sustainablelab/eurorack/readme-derivative.md

Derivative Work by Curry Goat Tea House

# Module builds in the USA
I am not changing the design. I simply wish to fab the boards by my usual flow
in the US and using parts available in the US. There changes are minor but
tedious. I hope to save others from repeating this effort.

These are minor changes to repo `github.com/pichenettes/eurorack.git`. The
changes allow me to build a similar module in the USA using a prototyping
turnkey service, either *MacroFab* or *PCB:NG*. For front panels, I either set
up files for laser cutting, or I order a bare PCB from *OSHPARK*.

The `pichenettes` design is for build in Europe. There are some BOM items
unavailable in the USA. Also, my PCB fab has different requirements from the fab
used by `pichenettes`. And my PCB assembly service only does surface mount. I
assemble the through-hole parts myself.

The purpose of the derivative work is a USA-compatible version. I only change
the PCB files and BOM files. I add my own PCB manufacturing files, and
supplement the front panel files with design files for laser cutter or PCB fab,
because I have access to these manufacturing services for prototyping
quantities.

I do not change the firmware. I do my best to keep this fork up to date with the
original `pichenettes` repo so that it always has the latest firmware.

## Stay up to date with design at `pichenettes`
I use Git to stay up to date. This is how the remotes are set up in my local
clone:

```bash
$ git remote -v
origin	https://github.com/sustainablelab/eurorack (fetch)
origin	https://github.com/sustainablelab/eurorack (push)
upstream	https://github.com/pichenettes/eurorack.git (fetch)
upstream	https://github.com/pichenettes/eurorack.git (push)
```

I sync to `pichenettes`:
```bash
git pull upstream master
```

And I push all derivative work to my fork. My fork is the remote repo you are
looking at now.

```bash
$ git push
```

# Boring repo additions
## EAGLE Project for latest work state
- [x] add an EAGLE project to the `eurorack` repo to store EAGLE state

The EAGLE project purpose is to save the state of the working environment for
the last PCB I was working with in the `eurorack` repo. It lowers the friction
in switching between `eurorack` work and my day-job work.

For example, if I am looking at the `shades` schematic and board files, I close
the project, not the files. Then when I reopen the project, those files open up.
Similarly, whatever libraries are active are reactivated, the grid settings in
the board file are loaded, etc.

## Private folder for invoices and receipts
- [x] add `_private`

`_private` holds paperwork no one else would be interested in: invoices and
receipts for parts orders and PCB orders.

# Price Module Builds
I use PCB:NG in Brooklyn. They are professional, have a quick turn time, and are
the cheapest prototyping service I know of. The only drawback is that they only
assemble surface mount parts. A lot of Eurorack parts are through-hole.

As ridiculous as it feels to pay $300-$500 for a module, there is no
cost-savings to order a single board. PCB:NG requires ordering six boards.
MacroFab allows ordering a single board, but the cost is very high. Set the
through-hole parts as DNP and the cost of a module like Shades or Ears is the
same as buying the module new. In addition:

- most modules have a metal panel,
    - I still need to laser cut a proxy for the front panel
    - in the case of Ears, the front panel is another PCB
    - this is cheap to order from OSHPark, but still, that's another PCB to
      order!
- I still need to solder the through-hole parts by hand
- I have to deal with procuring the 3.5mm jack that matches the PCB footprint

# Eurorack module design
The Eurorack standard comes from the Eurorack card standard for inserting PCB
cards into a rack-mounted backplane. Eurorack eliminates a lot of the
requirements to reduce the module COGs (cost of goods). The power supply bus
cabling replaces the backplane. It is a defacto standard. Much of Eurorack is a
defacto standard. You won't find a single-answer for compatibility. Just look at
popular modules. Since Mutable Instruments is open-source, and derivative
modules are open-source, I use this as my reference. I also have a Moog case
that I take measurements from.

## Jacks
This took me by surprise. Jacks are in no way standardized. The PCB footprint
for the jack in a module design *must* match the specific jack if the jack pins
solder directly to the PCB. So, jacks. Here we go.

### Background
Jacks come with different diameters, mono or stereo, switched or unswitched, and
panel mounted (solder wires to the jack pins) or PCB mounted (jack pins solder
direct to the PCB).

The typical Eurorack jack is a 3.5mm, mono, switched, PCB-mounted jack.
Most Eurorack modules mount the PCB parallel to the front panel, so the jack
pins are axial with the jack.

### function of the three pins on a switched mono jack
The three pins are tip, sleeve, and a normally-close (N/C) switch.

The two important pins are sleeve and tip. These carry the signal on the audio
cable. Sleeve ties to a 0V reference in the circuit. Tip is the signal input or
output.

The switch pin functionality depends on the module. Normally-closed means the
switch pin shorts to the tip when no cable is inserted and opens when a cable is
inserted. There's a surprising number of clever ways to use such switch action.
Here are three examples from Mutable Instruments.

### switch pin usage examples from Mutable Instruments

#### Elements
- all the jacks on Elements do not use the switch connection
- the switch pin is left unconnected

#### Ears
- the sleeve pin connects to a `0V` reference
- the piezeo element is a two-terminal device
    - one terminal ties to the `0V` reference
- the switch pin connects to the other terminal of the piezo element
- when nothing is plugged into the jack, the switch pin shorts to the tip pin,
  so the piezo element connects to the input stage
- when a device is plugged in, the switch pin opens and the piezo element is no
  longer connected to the input stage

#### Shades
- all the jacks on Shades use the switch connection
- the default reference to the jack inputs is `0V`
- the switch pin, in conjunction with the three-pin header, provides an
  alternative default reference to the jack inputs of either `+5V` or `+10V`
- design:
    - tie the switch to the middle pin of a three-pin header
    - the outer pins are voltage references
    - the three-pin header is not accessible via the front panel
    - the user puts a jumper on the three-pin header prior to installing the
      module in their eurorack
    - the jumper ties the `switch` pin to either `+5V` or `+10V`
    - so the input to the jack can default to `+5V` or `+10V`
    - removing the jumper results in defaulting to `0V` because the op-amp
      is in a negative feedback configuration:
        - non-inverting terminal is tied to a `0V` reference
        - therefore the inverting terminal is driven to `0V`
        - the jack tip pin is connects to the inverting terminal via the
          the `10kΩ` pot and the `100kΩ` resistor

### Threaded
The jacks take a lot of abuse, so they must be attached to the front panel via a
threaded nut. Otherwise the constant plugging and unplugging of patch cables
could damage the jack solder joints or the stress could transfer to the PCB the
jack is mounted on.

This threaded nut requirement is peculiar to Eurorack. Headphone and USB jacks
on regular consumer electronics have a similar concern, and those are only PCB
mounted, and surface mount at that! But the stress in a Eurorack and the
reliability demands are greater. Jacks in consumer electronics are almost
always at a right angle to the PCB, so plugging a cable does not transfer the
stress to the PCB. And to protect the solder joint of the jack, there is usually
a pair of mounting pins that constrain the jack position on the PCB. Eurorack
usually requires the PCB and front panel planes to be parallel, and the number
of plugging/unplugging cycles is *much* higher. And unlike a consumer headphone
jack, once a Eurorack module jack starts to go, the module is unusable.

### Beware of variety and availability
- there are *many* 3.5mm mono jacks that solder to a PCB
- as of this 2019 writing, *none* of the ones used in Eurorack designs are
  available from the usual US vendors (Mouser, Digi-Key, Newark, etc.)!
- in the US, *all* of the threaded 3.5mm jacks are right-angle
    - many of these are confusingly labeled *vertical*
    - the *vertical* does not refer to the dimension required by the Eurorack
      build
        - the pins are *not* axial with the jack
        - the pins are still at a right-angle to the jack
    - so these *vertical* jacks are essentially also right-angle
- hence, I am motivated to investigate designs with the PCB perpendicular to the
  front panel

### OK to substitute a mono jack with a stereo jack
Stereo jacks are OK too. On a stereo jack, in addition to the sleeve and tip
there is a ring pin. Leave the ring pin not connected.

The ring pin shorts to the sleeve pin when a mono plug is inserted into a stereo
jack. The ring pin floats when unplugged.

So, for example, to reduce part count and possibility for jack mix-up during
assembly, a stereo-to-mono breakout can use *all* stereo jacks. The stereo jacks
acting as mono jacks become mono simply based on the PCB traces.

### Jacks on Mouser for perpendicular-pcb
Here is the Mouser page with the Switchcraft 35RAPC family of jacks:
<https://www.mouser.com/Switchcraft/Connectors/Audio-Video-Connectors/Phone-Connectors/35RAPC-Series/_/N-778cv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>

Select a suitable stereo jack from this list and make a stereo-to-mono breakout
with it.

### Jacks on Mouser for parallel-pcb
Here is the Mouser page with the most likely candidates for Eurorack-style jacks

<https://www.mouser.com/Connectors/Audio-Video-Connectors/Phone-Connectors/_/N-778cv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>

- Amphenol# ACJM-MV35-2S is the ideal jack:
    - 3.5mm
    - threaded: the `MV` is for threaded metal?
    - mono (has sleeve and tip pins, the first `M` is for mono)
    - switched (has a switch pin, the final `S` is for switched)
    - purchase 100 from Master Electronics for $70.20 plus $9 shipping
        - they have a minimum order service fee for orders under $50, so
          ordering quantity 10 is not much cheaper than quantity 100
    - [x] purchase 100 on 2019-08-27, order confirmation# M39230
        - ships tomorrow via UPS ground
        - sub-total: $70.20
        - shipping: $8.99
        - tax: $6.1776
        - total: $85.3676
- Amphenol# ACJS-MV35-3S is the stereo version of the switched mono jack
    - this is fine
    - just leave the ring pin unconnected
- Amphenol# ACJM-MV35-2 is OK if I don't need the switch pin
- Amphenol# ACJS-MV35-3 is the stereo version of the no-switch jack
    - also OK if I don't need the switch pin
    - just leave the ring pin unconnected
    - another stereo no-switch jack is Kobiconn# 161-MJ355W-EX
    - the incentive of this part is that it is unlikely to go out of stock
    - but the Amphenol inventory is not bad, between Mouser and Master
      Electronics
- Since I'm ordering from Master Electronics, I decided to get 50 of the mono
  jack and 20 of the stereo jack. It's enough jacks for now. By the time I need
  more, they should be back in stock at Mouser. And the switched stereo version
  is not even stocked at Mouser. Ah no, the stereo are on back-order. So just
  the mono then.
- The mono and stereo, switched and not-switched, are all interchangeable as
  long as I always use the pin out for the case with the most pins: the stereo
  switched. This lets me use any jack on any board. That kind of
  interchangeability would be confusing if I was making products to sell, but
  it's great for making one-offs for myself and not being *stuck* when the
  vendors run out of stock on the parts with less pins. I could always cut the
  pins off, but it's cleaner to just add the extra holes on the board. The only
  case against this is if it eats up valuable PCB real estate.

## QingPu WQP-WQP518MA, Thonkiconn PJ301M12, now Thonkiconn PJ398SM
Mutable Instruments uses Thonkiconn# PJ301M12, which is actually QingPu#
WQP-WQP518MA. The part is now Thonkiconn# PJ398SM.

It has three pins that are axial with the jack so that the jack is oriented
vertical to the PCB. The pins are intended for through-hole soldering. The pins
do not have loops for chassis wiring.

All 3.5mm jacks work with the same plugs. But the PCB layout is specific to each
jack. See <http://www.qingpu-electronics.com/en/products/WQP-PJ398SM-362.html>.

The layout for this particular part has two pins close together. The two
close together are the sleeve and switch. The sleeve pin is the one that
sticks out the side of the jack. QingPu bends this pin down so that it runs down
to the PCB like the other two pins. The pin farthest away is the tip.

### Procurement of Eurorack jacks
Procuring the jacks sucks. Options are attempting to buy direct from China, or
procuring from a vendor in Europe.

- send an inquiry to QingPu:
<http://www.qingpu-electronics.com/inquiry-en.asp?id=362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>

- buy from the Thonkiconn in the UK:
<https://www.thonk.co.uk/shop/thonkiconn/>

## Jack options for modules with perpendicular PCBs
- [ ] explore jack options for PCBs perpendicular to the front panel
    - this orientation works on small PCBs
    - what is the maximum depth the PCB can protude into the case?
    - small PCBs are simple *glue* modules (stereo-to-mono, transducer
      amplifiers, attenuators, mixers, one-to-many breakouts, gate manipulation)
    - on these designs, a right-angle jack is fine
    - the restriction on the type of module this works with is that, unless the
      jacks are panel mount, the panel is restricted to a single column of
      *everything*, so the front panel design must work as a narrow vertical
      layout
    - start with the stereo-to-mono design
- [ ] design a PCB that takes a stereo input and splits it into two mono
  outputs
    - use jacks for right-angle
    - should I:
        - duplicate the design as much as possible along the height of the PCB?
        - or add a second design to this module?
    - design a PCB as the front panel
    - include artwork to indicate:
        - which three jacks belong together
        - which ears are stereo/mono
    - [ ] what are the physical dimension requirements for the front panel
    - [ ] what is the maximum width (case depth) for the module PCB?
    - [ ] identify the jacks to use
        - do not use the straight mono jacks purchased from Master Electronics
        - the whole point is this design gets away with the typical USA jacks
        - also, maybe I can even go completely surface mount on this, in which
          case the jack does not need to be threaded, but it should have
          mounting pins to constrain it in the plane of the PCB
            - If an SMT threaded vertical jack exists, I'll try it, but it
              sounds exotic. I cannot find anything like this, not even from
              QingPu. So an SMT jack is *not* going to be threaded

## Price a PCB at MacroFab
- upload `.brd` file
- disregard all unassigned files
    - these are EAGLE layers that are not necessary
    - the other layers look OK
    - but take a closer look before ordering
    - this is for pricing info only
- do not need to make a BOM:
    - MacroFab does a decent job of picking parts where the `VALUE` is something
      reasonable
    - but some parts require intervention
    - look at the `.xlsx` BOM in the `hardware_design` folder
    - or manually inspect the part:
        - left-click to select part
        - select `Open Footprint`
        - measure the footprint artwork to find out which part it is

- the 
- the PCBs have no front panel
- I have to 

- Mutable Instruments designs are 2-layer.
- DRU with conservative values:

```powershell
C:\chromation-dropbox\Dropbox\eagle\dru\PCB-NG\Conservative-clearance-check-before-2-layers-PCB-NG.dru
```

- CAM job:

```powershell
C:\chromation-dropbox\Dropbox\eagle\cam\PCB-NG\pcbng2layer-for-EAGLE-9.cam
```

## Shades
- no microcontroller
- perfect candidate for ordering as-is
- I touched up silly errors: wire stubs, angles, and clearances
- I left the Keepout and Stop Mask errors
- PCB:NG only assembles surface-mount
- [ ] generate an xyrs for the surface-mount parts
- [ ] generate a Mouser cart for through-hole parts

### PCB:NG Cost
- boards only are $231 for 6, so it will probably be about $300 for 6 with the
  SMT parts, that is $50/unit plus the cost of the through-hole parts and the
  time it will take me to solder them
- Shades is $119 new
- do not order Shades as-is
- *use* Shades in a design with Ears

### MacroFab Cost
- parts I entered manually:
- C5 and similar 22pF, selected part is not available
    - substitute
    - Murata# 81-GRM1885C1H220GA1J
    - with
    - Vishay VJ0603A220GXACW1BC
- C1 and C2:
    - footprint shows 4mm diameter cap
    - based on this diameter and the capacitance, the part is either rated for
      16VDC, 25VDC, or 35VDC:
        - <https://www.mouser.com/datasheet/2/315/ABA0000C1145-947633.pdf>
    - I picked the 35VDC part
    - Panasonic# `EEE-FK1V100UR`
    - nevermind, BOM shows the 25VDC part
    - go with what's on the BOM

# Contact Microphones for Ears
- the basic design is from
  <https://www.instructables.com/id/Make-a-Contact-Microphone/>
- the instructables uses the same family of piezo element used in Ears

## Goals
The goal of this contact microphone project is to input acoustic instruments to
Ears. But I want to do this in two ways:

1. simple: just input to Ears, good for one instrument per Ears
2. more involved: input multiple contact microphones to a pre-amp hub, copying
   the design from Ears but ignoring the envelope following part, and including
   a mixer section like Links or Shades

## BOM for a contact microphone

### [ ] try different size piezo elements
- the instructables points towards the Murata `7BB` buzzers as piezo element

#### Ears piezo element
- Ears uses the same family of piezo elements
    - the Ears BOM shows:
    - `Murata Electronics# 7BB-20-6L0`
    - the `L0` means it is sold with 2-inch leads already soldered on
    - get 10 because this is what Ears uses, so if I make Ears, I have the same
      part
    - [x] purchase 10 from Digi-Key on 2019-08-26

#### Instructables piezo element
- the instructables recommends a larger 27mm diameter piezo element
    - the larger size is probably so that it fits snug in a standard bottlecap
- here is the 27mm diameter microphone piezo element:
    - `Murata Electronics# 7BB-27-4`
    - `Digi-Key# 490-7713-ND`
    - $6.55 for 10
    - get 10 because this is what the instructables uses
    - [x] purchase 10 from Digi-Key on 2019-08-26
- and the same part but with 2-inch leads already soldered on:
    - `Murata Electronics# 7BB-27-4L0`
    - get 1 with leads for a quick test
    - [x] purchase 1 from Digi-Key on 2019-08-26

#### Smallest in family
- maybe smaller works better for some instruments?
    - the smallest in this series is 12mm diameter
    - `Murata Electronics# 7BB-12-9`
    - get 1 for testing, unfortunately not available with leads already on
    - [x] purchase 1 from Digi-Key on 2019-08-26

#### Largest in family
- or maybe larger?
    - the largest in the series is 41mm diameter
    - with 2-inch leads already soldered on
    - `Murata Electronics# 7BB-41-2L0`
    - get 1 with leads for a quick test
    - [x] purchase 1 from Digi-Key on 2019-08-26

### [ ] figure out which audio cable to use
- I am looking at two from Tensility
- both have:
    - shield
    - 3.5mm mono plug (tip/ring)
- they differ on the end with the tinned conductors
- the first has:
    - tip and ring conductors tinned
    - shield is exposed but there is no tinned conductor
- the second has:
    - tip, ring, *and* a tinned shield conductor
- I think I want the first cable, not the second
- the shield is only supposed to connect on one end
- therefore, I'm guessing that:
    - the first connects the shield to the ring at the mono plug
    - the second does not connect the shield at the mono plug since it is made
      available for connection at the tinned conductor end
- [x] buy both
- [ ] do a continuity test to see which has the shield connected internally

#### Tensility International Corp# `10-00343`

<https://tensility.com/cable-assemblies/audio-video-cables/mono-cables/10-00343>

- `Digi-Key# 839-1038-ND`
- $3.20 for 1
- $30.69 for 10
- specifications:
- 6-ft length
- shielded
- Eurorack end:
    - 3.5mm mono plug
    - Tensility# 50-00399
    - https://tensility.com/connectors/50-00399
- Piezo-soldering end:
    - 5mm-length, bare, tinned, 28AWG conductors
    - tip conductor has red jacket
    - Tensility# 30-00177
    - https://tensility.com/wire/30-00177
- shield:
    - spiral and foil
    - do not solder to piezo element
    - [ ] is this internally connected to the shield at the mono plug?
- [x] purchase 3 from Digi-Key on 2019-08-26

#### Tensility International Corp# `CA-2205`

<https://tensility.com/cable-assemblies/audio-video-cables/mono-cables/053-0279r>

- `Digi-Key# CP-2205-ND`
- $3.62 for 1
- $34.71 for 10
- specifications:
- 6-ft length
- shielded
- Eurorack end:
    - 3.5mm mono plug
    - Tensility# 50-00120
    - https://tensility.com/connectors/50-00120
- Piezo-soldering end:
    - bare, tinned, 24AWG conductors
    - tip conductor has red jacket
    - ring conductor has black jacket
    - shield is tinned as a third conductor with a heatshrink jacket
    - Tensility# 30-00005
    - https://tensility.com/wire/30-00005
- shield:
    - spiral and foil
    - shield is also broken out to a tinned wire, so...
    - solder to piezo element?
    - [ ] is this *not* internally connected to the shield at the mono plug?
- [x] purchase 1 from Digi-Key on 2019-08-26
