sustainablelab/eurorack/(commit log)

2019-08-27 shades: apply PCB:NG DRC and fix silly DRC errors: wire stubs, angles, conservative trace-space clearance.
    [shades_v30.brd]
2019-08-28 WIP: update Shades BOM: caps are end of life and jack part number changed. Done: find substitute jack for sourcing in the US.
    [Shades.xlsx]
2019-09-03 Add `_private` folder for invoices and receipts. Start with non-powered module designs. WIP: design stereo-to-mono breakout module. WIP: design manual attenuator module.
